tranthamkw/RCA-SBC256-SELECTRON/Images/IMG_1172.jpeg

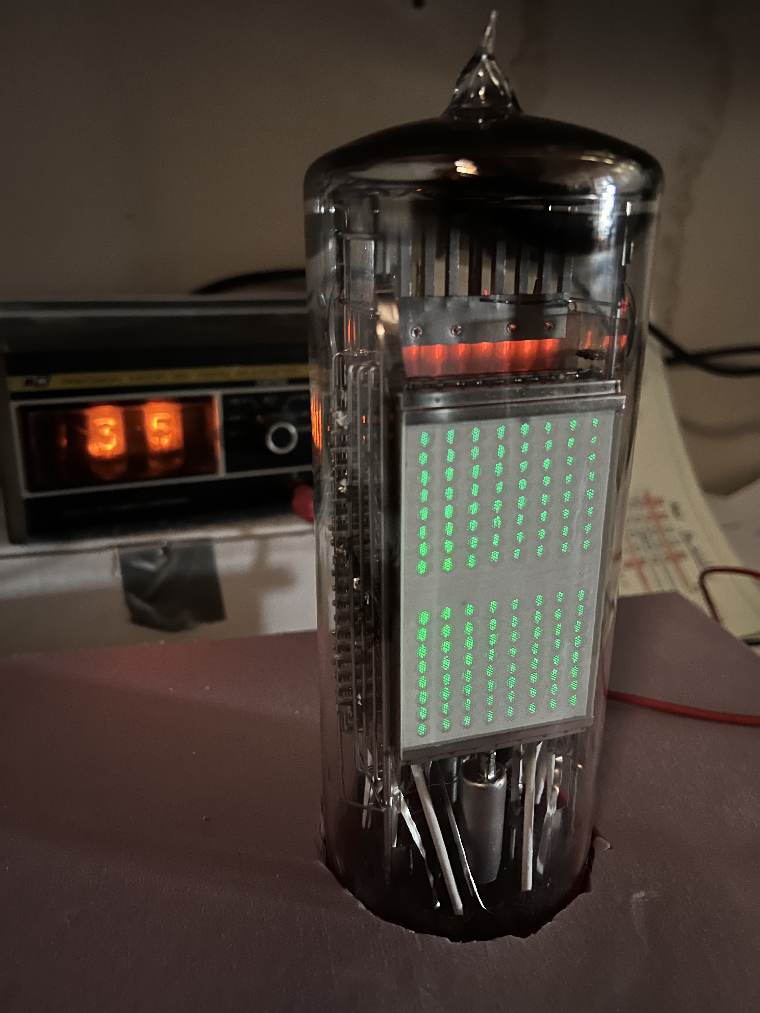
Images/IMG_1172.jpeg
