tranthamkw/RCA-SBC256-SELECTRON/Images/IMG_1291.jpeg

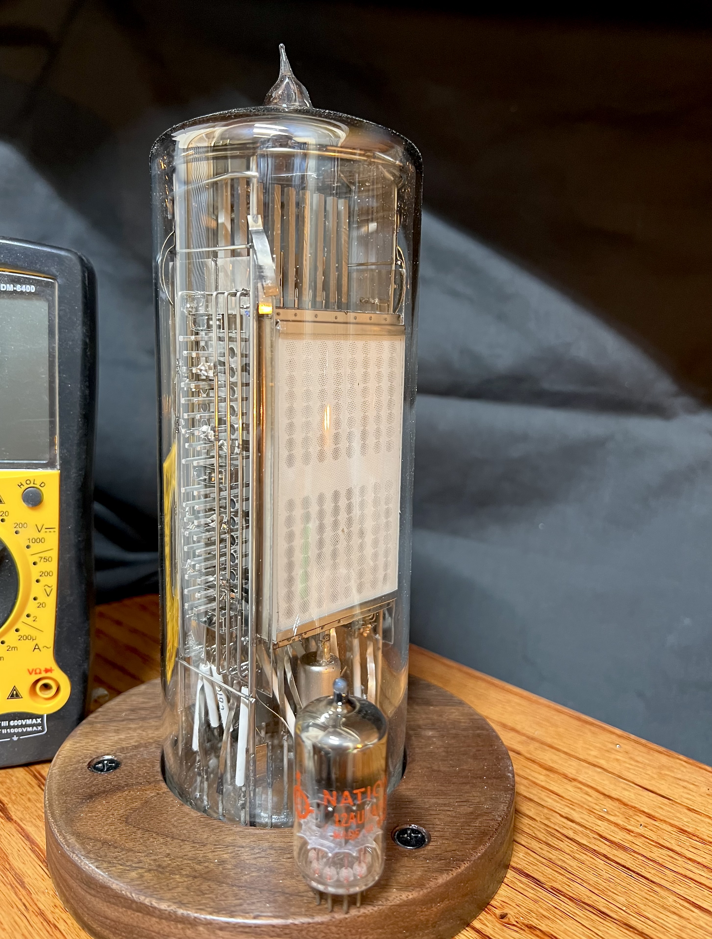
Images/IMG_1291.jpeg
