tranthamkw/RCA-SBC256-SELECTRON/barDriver/Selector Bar driver.docx

Selector Bar driver

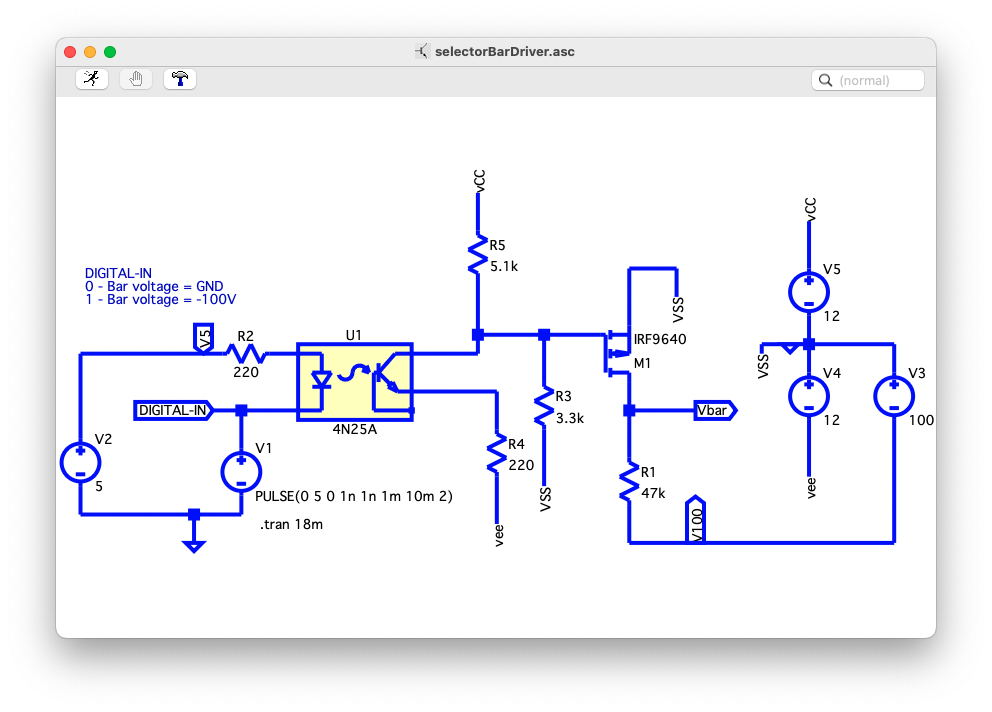
[picture p9: figure]
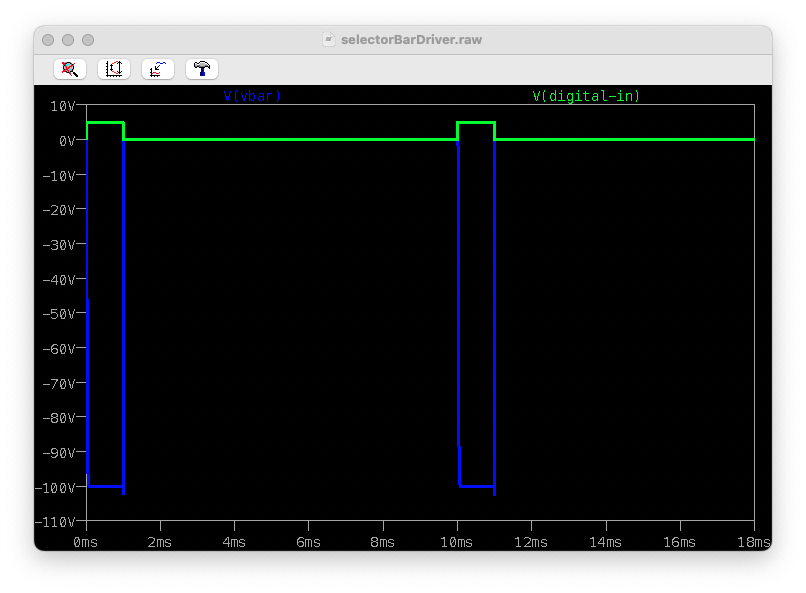
[picture p10: figure]
