tranthamkw/RCA-SBC256-SELECTRON/BarDecoder/BarDecoder.png

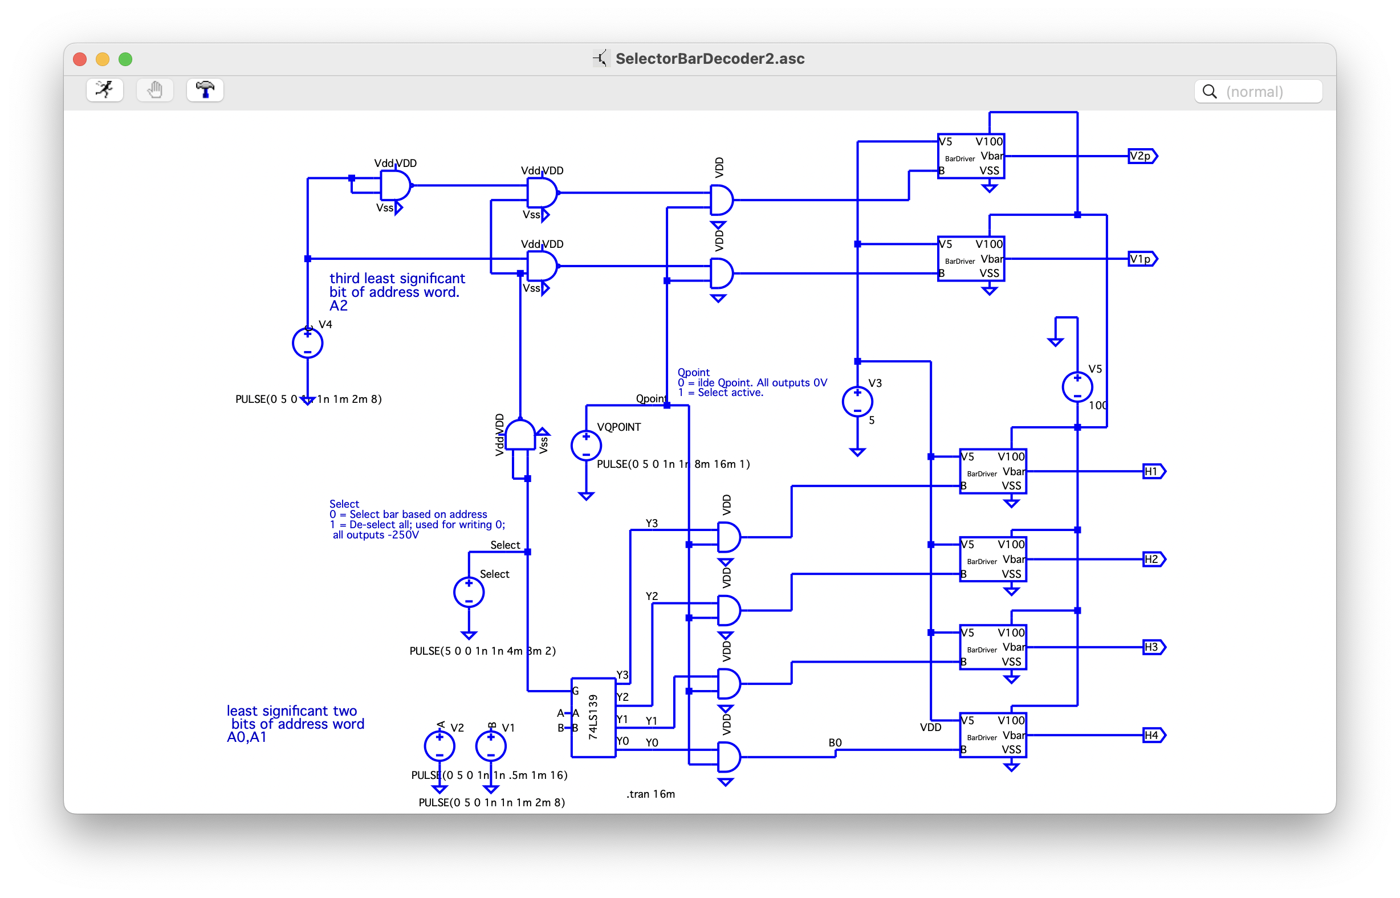
BarDecoder/BarDecoder.png
