tranthamkw/RCA-SBC256-SELECTRON/BarDecoder/IMG_1390.jpeg

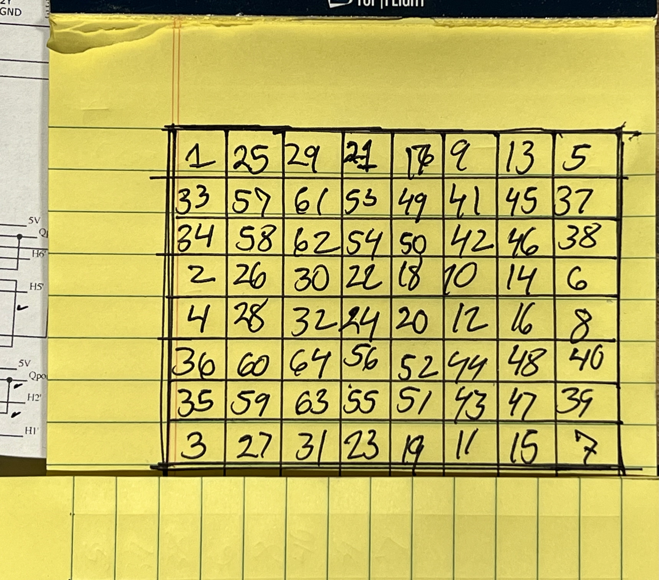
BarDecoder/IMG_1390.jpeg
