tranthamkw/RCA-SBC256-SELECTRON/barDriver/QuadDriverArrangement.png

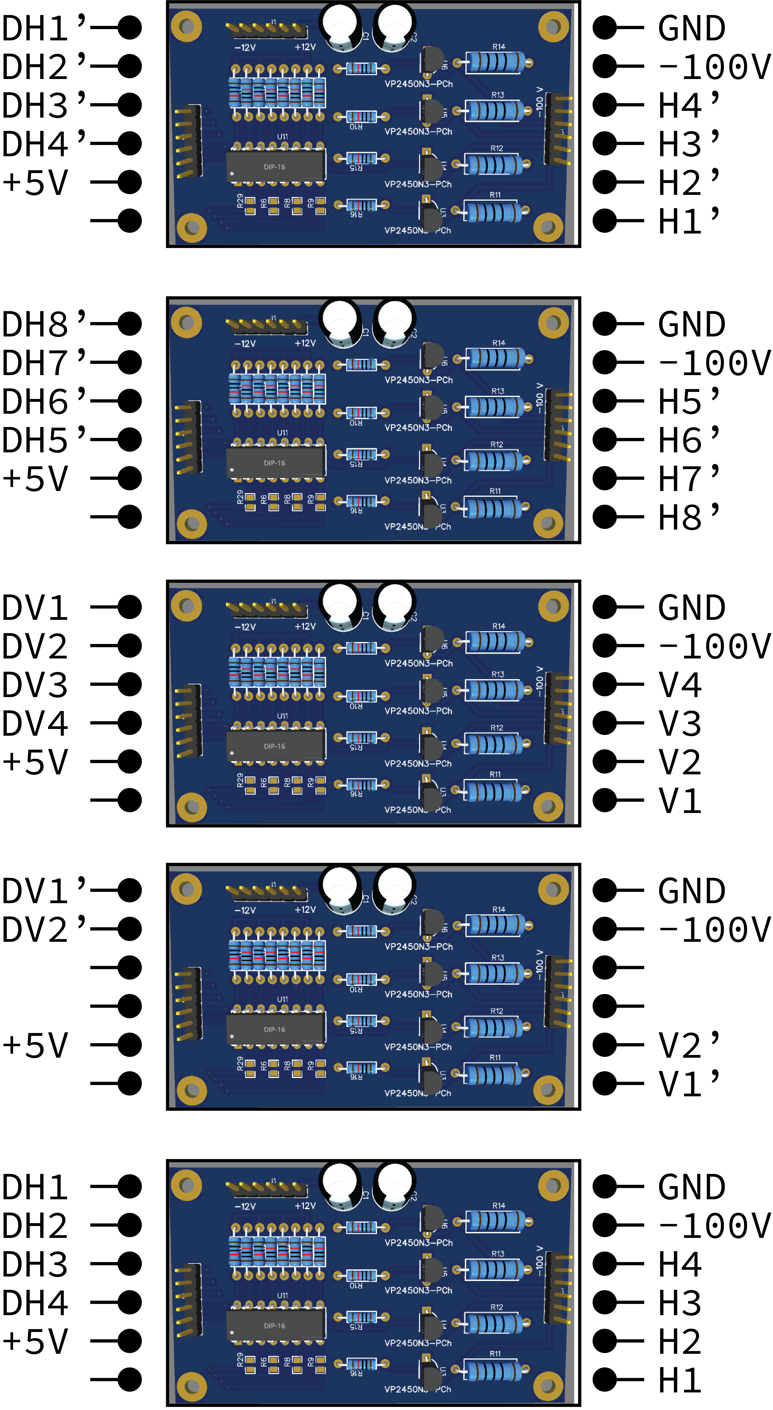
barDriver/QuadDriverArrangement.png
