tranthamkw/RCA-SBC256-SELECTRON/PIC/IMG_012.BMP

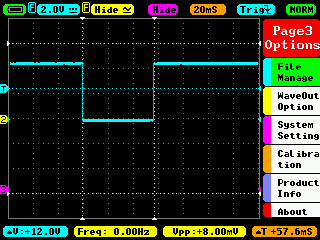
PIC/IMG_012.BMP
