tranthamkw/RCA-SBC256-SELECTRON/SchematicBlockDiagram.pdf

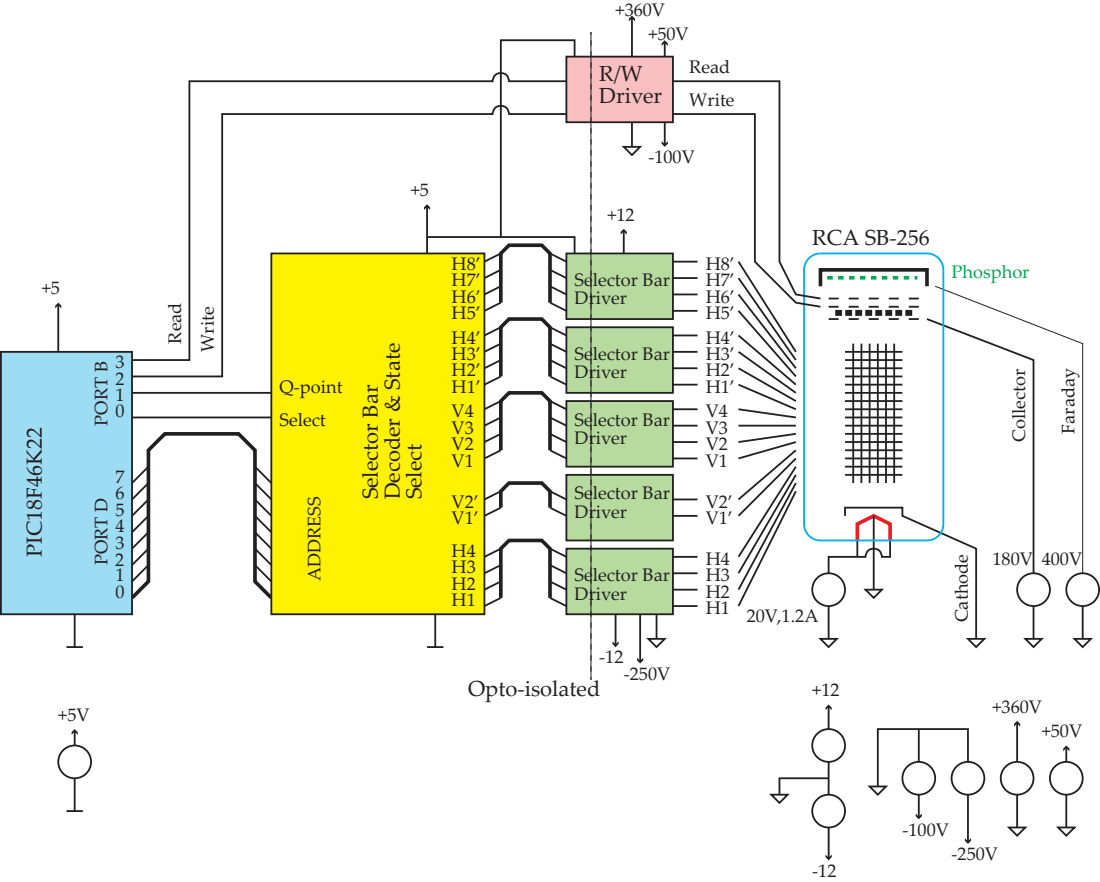
[picture p26: page 1]
PORT D; ADDRESS; Q-point Select; PIC18F46K22; PORT B 0 1; Write; Selector Bar Driver; Collector; Read; Cathode; Faraday; Phosphor; Selector Bar; Decoder & State; Select; Opto-isolated; R/W Driver; RCA SB-256
