tranthamkw/RCA-SBC256-SELECTRON/ReadDetector/Schematic_READ_AMPLIER_2026-07-07.pdf

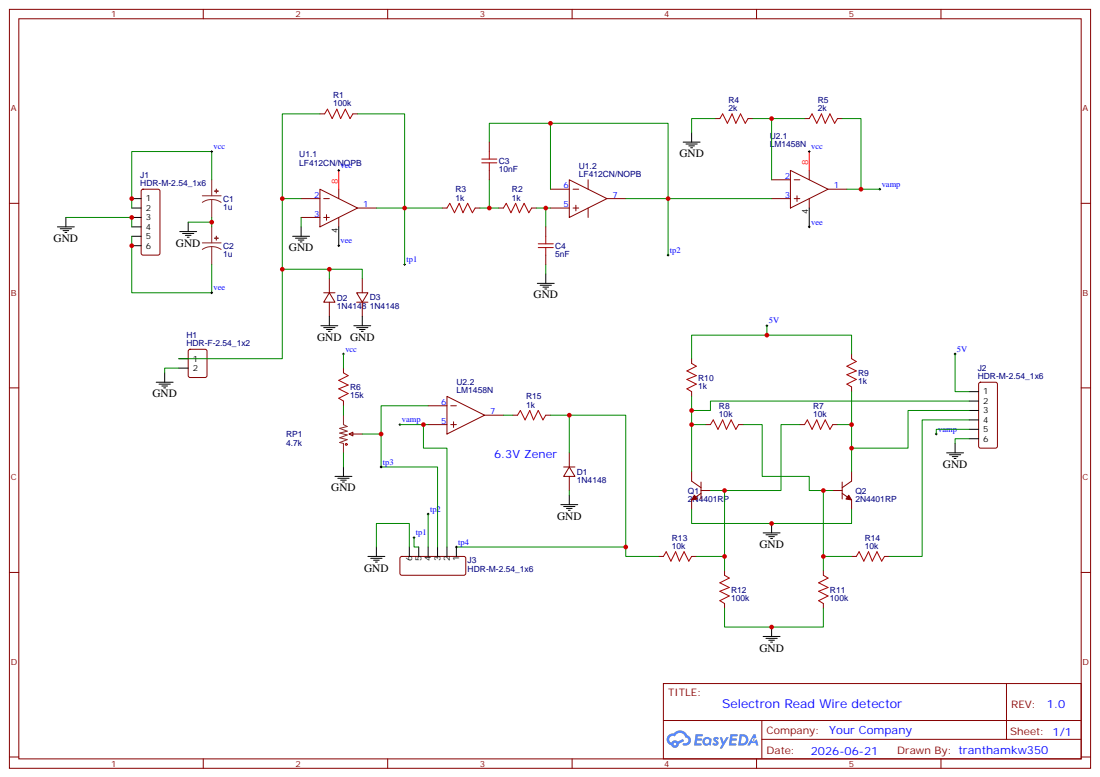
[picture p27: page 1]
