tranthamkw/RCA-SBC256-SELECTRON/ReadDetector/Schematic_READ_AMPLIER_2026-06-25.pdf

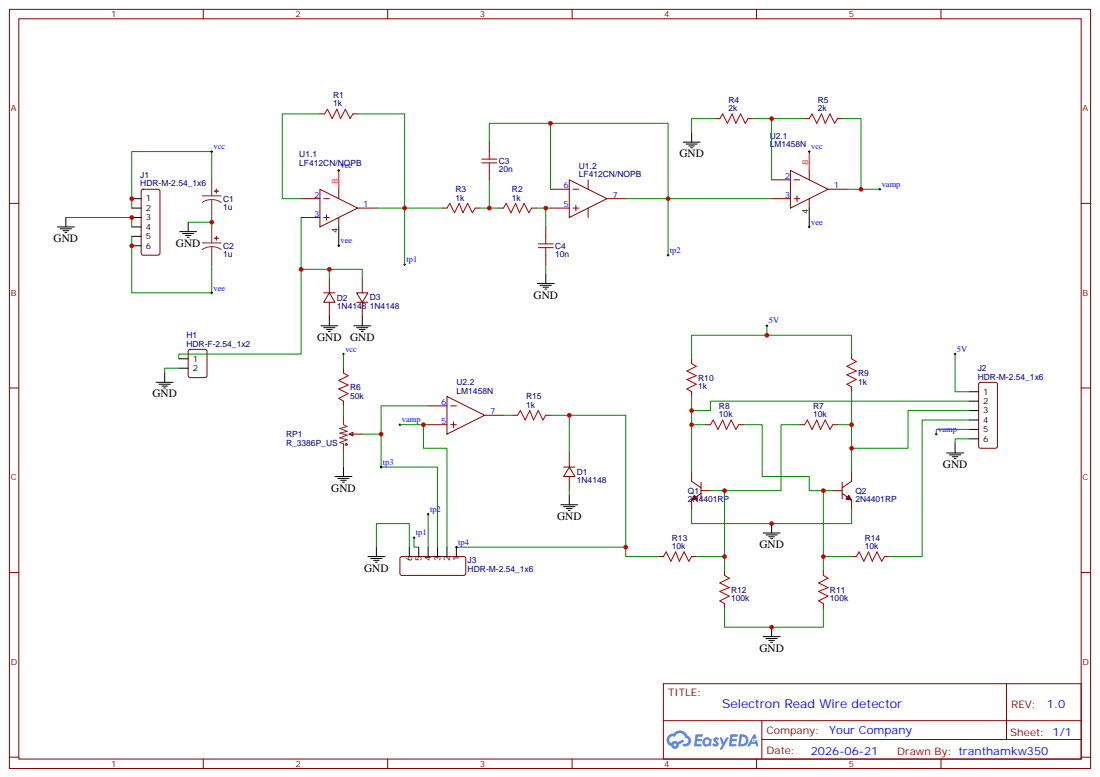
[picture p28: page 1]
