tranthamkw/RCA-SBC256-SELECTRON/PIC/Schematic_18f22k22-TEST_2026-06-07.pdf

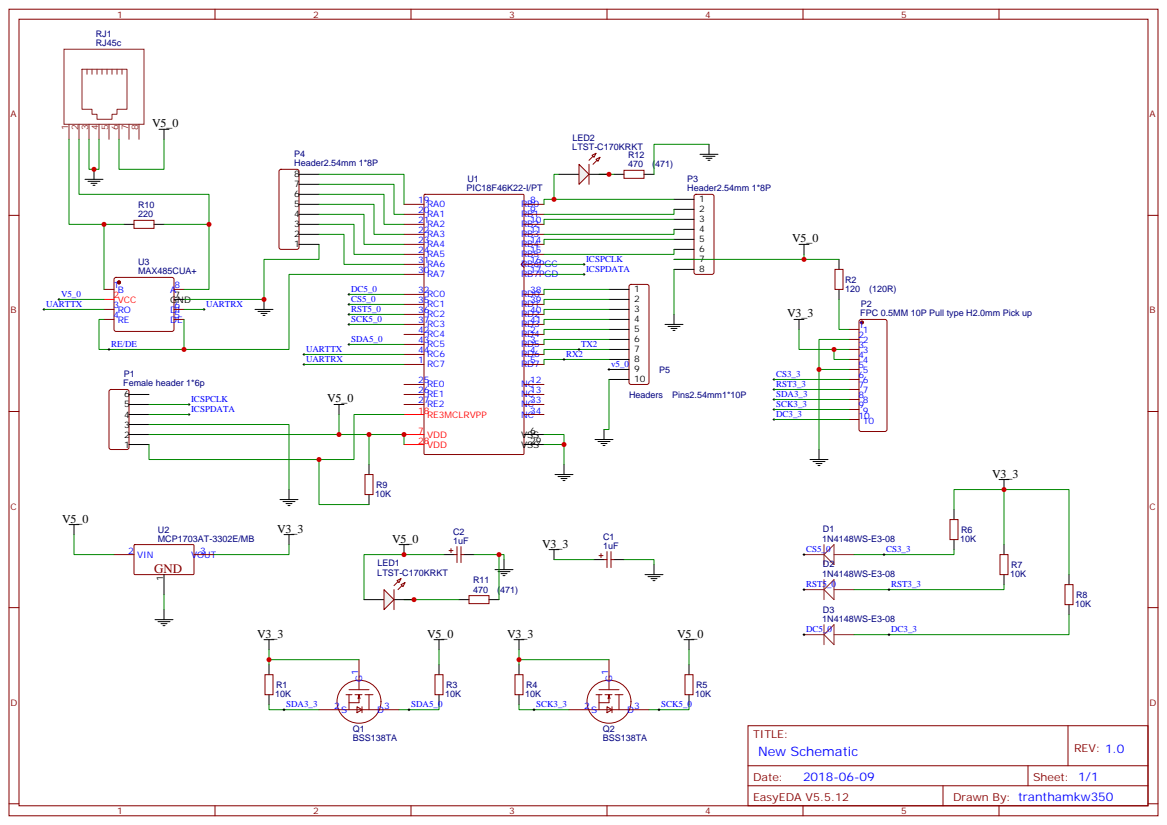
[picture p29: page 1]
