tranthamkw/RCA-SBC256-SELECTRON/BarDecoder/Schematic_SBC256BarSelector_2026-06-07.pdf

## 3B10 4Y11 4A12 4B13 VCC 14

## 3B10 4Y11 4A12 4B13 VCC 14

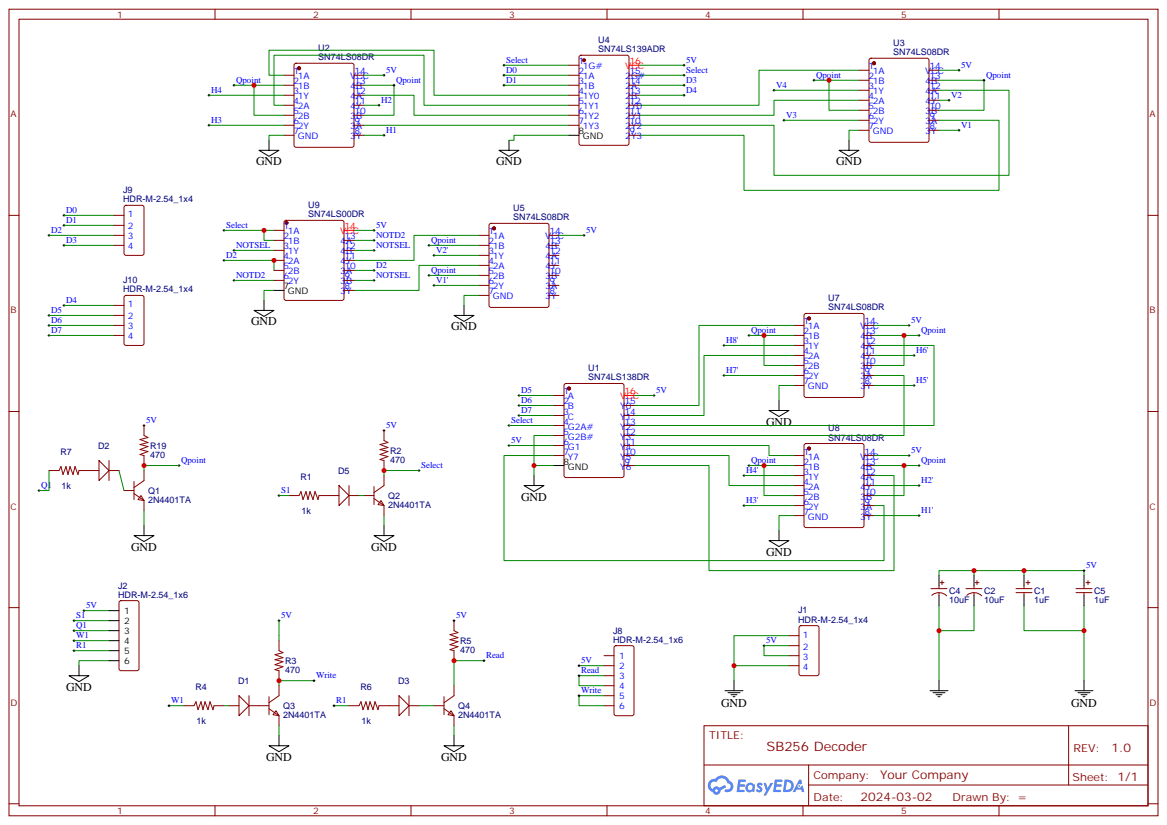
[picture p30: page 1]

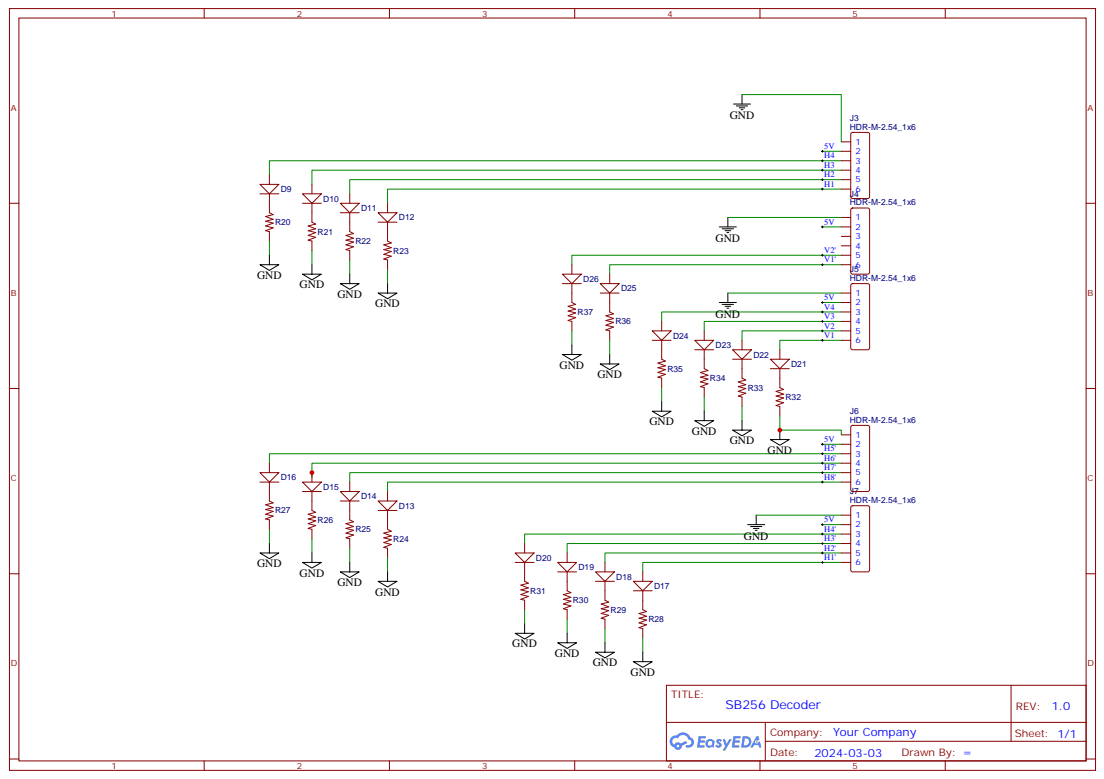
[picture p31: page 2]
