tranthamkw/RCA-SBC256-SELECTRON/ReadWriteDriver/Schematic_sb256READ-WRITE_2024-04-03.pdf

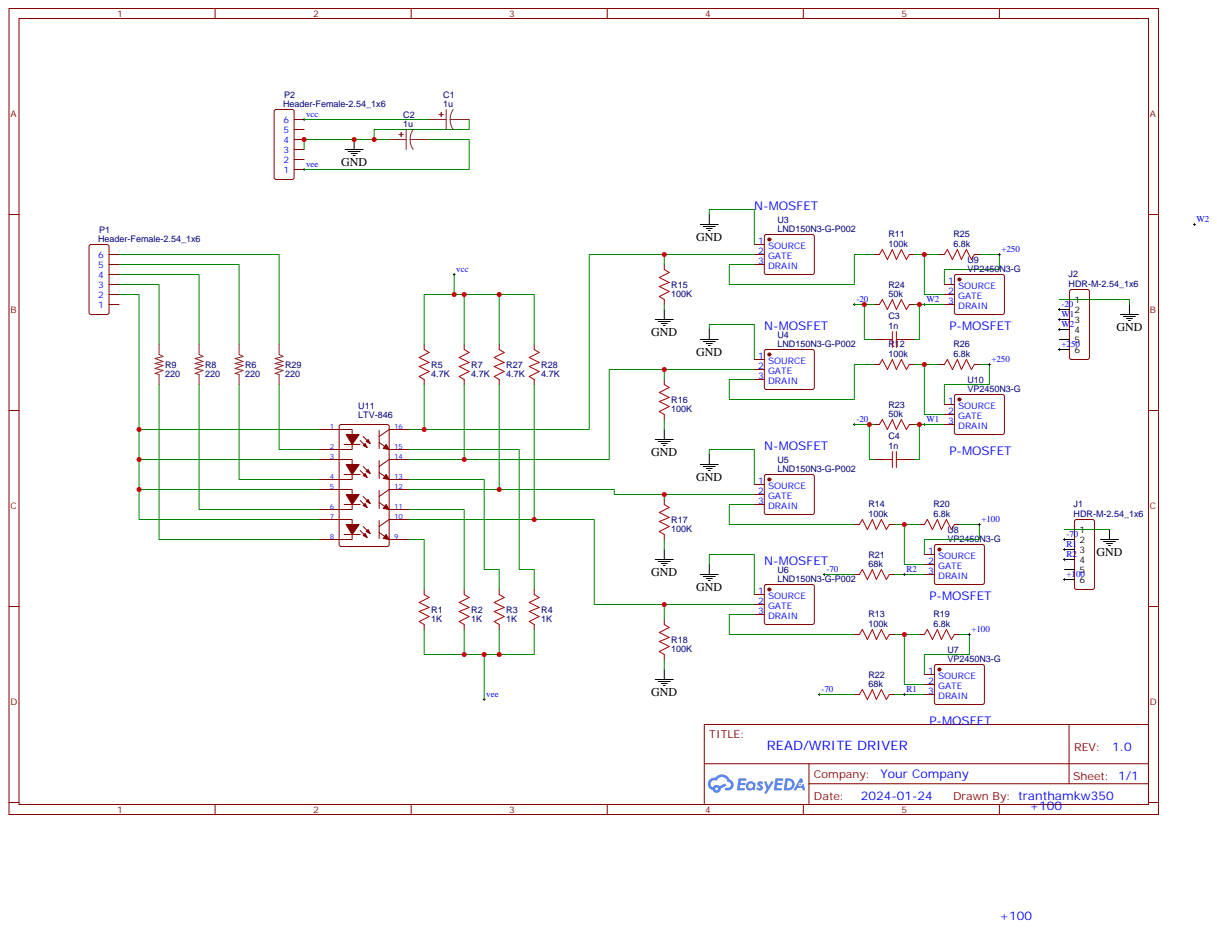
[picture p32: page 1]
