tranthamkw/RCA-SBC256-SELECTRON/BarDecoder/DRAFT_Schematic_SBC256BarSelector_2024-04-03.pdf

# 2Y2 10 2Y1 11 2Y0 12 2B 13 2A 14 2G# 15 VCC 16

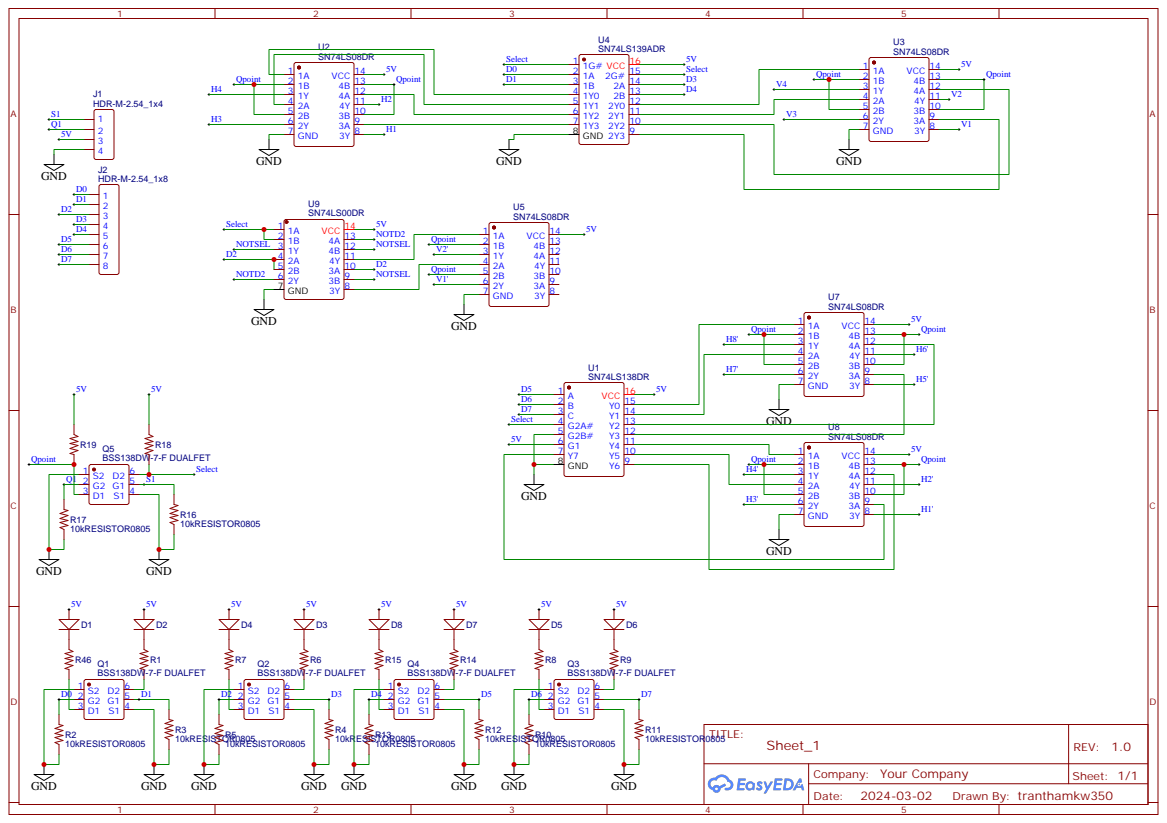
[picture p33: page 1]
