tranthamkw/RCA-SBC256-SELECTRON/barDriver/Schematic_sb256driver_2024-03-03.pdf

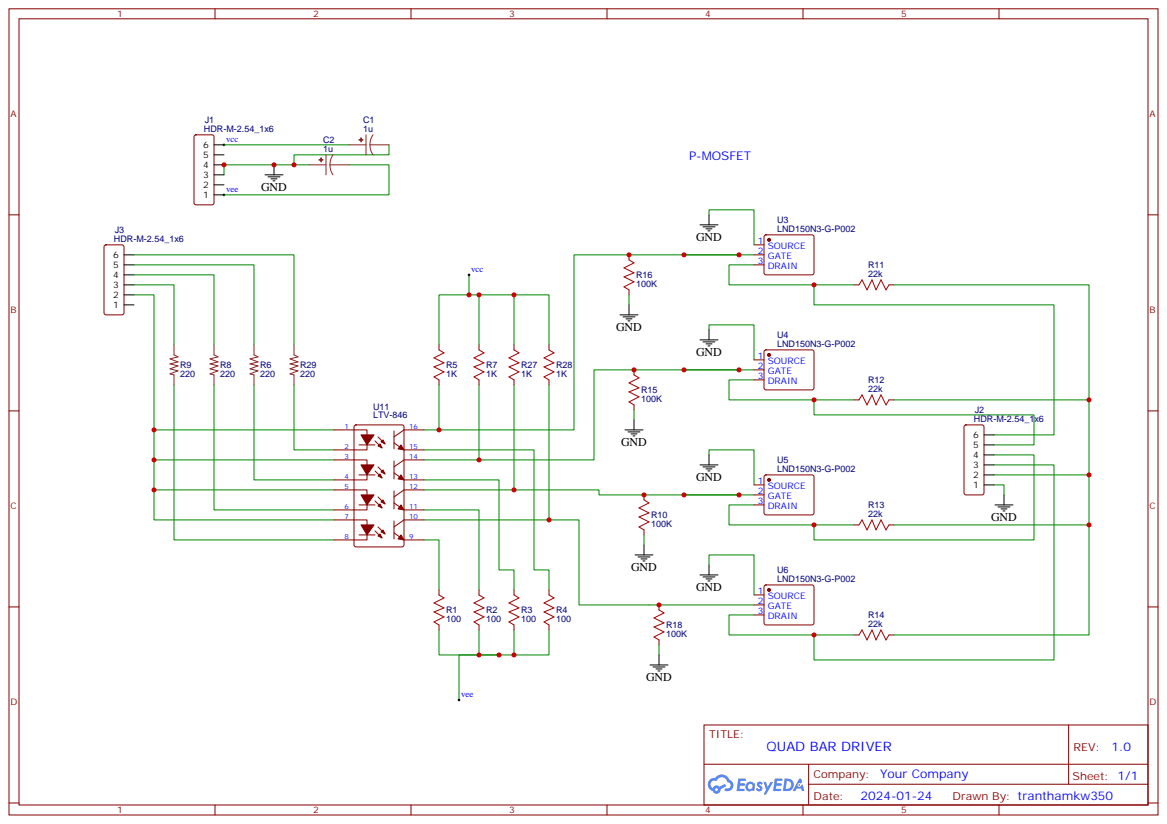
[picture p34: page 1]
