tranthamkw/RCA-SBC256-SELECTRON/ReadWriteDriver/eyeletSimWriting0.asc

C1: cap; 1p
C2: cap; 1p
Collector: voltage; 180
EyeletCurrent: bi; I={if((time<10u)|(time>15u),453.345u*exp(-0.000399261*(-114.956+V(eyelet))**2)-124.818u*exp(-0.00186908*(-31.0809+V(eyelet))**2)-388.297u/(1+exp(-0.0622775*(-155.076+V(eyelet)))),0)}
V3: voltage; PULSE(0 -250 10u 1n 1n 5u 20u 1)
WritePlate: voltage; PWL(0 0 5u 0 5.01u 360 10u 360 15u 0 20u 0)
Named nets: 0, Eyelet, Collector, WritePlate, SELECTOR-BARS
.tran 0 20u 0 100p
.ic V(eyelet)=180
