tranthamkw/RCA-SBC256-SELECTRON/ReadWriteDriver/readPlateDriver.asc

M1: pmos; IRF9640
M2: nmos; BSC100N10NSF
R1: res; 100k
R2: res; 10k
R3: res; 420
R4: res; 4.7k
R5: res; 1k
R7: res; 100k
R8: res; 5.06k
U1: 4N25
V1: voltage; 70; Rser=5
V2: voltage; PULSE(0 5 0 1n 1n 1m 10m 5)
V3: voltage; 100; Rser=5
V4: voltage; 12
V5: voltage; 12; Rser=5
V6: voltage; 5; Rser=0
Named nets: 0, vee, vCC, g, s
.tran 50m
S
D
G
