tranthamkw/RCA-SBC256-SELECTRON/ReadWriteDriver/writePlateDriver.asc

C1: cap; 2n
M1: pmos; IRF9640
M2: nmos; BSC16DN25NS3
R1: res; 100
R2: res; 50k
R3: res; 220
R5: res; 100K
R7: res; 100k
R8: res; 6.8k
R9: res; 4.7k
U2: 4N25
V1: voltage; 5; Rser=0
V2: voltage; PULSE(0 5 0 1n 1n 1m 10m 5)
V3: voltage; 250; Rser=5
V4: voltage; 12
V5: voltage; 12; Rser=5
Named nets: 0, vee, vCC
.tran 50m
