tranthamkw/RCA-SBC256-SELECTRON/BarDecoder/SelectorBarDecoder2.asc

Select: voltage; PULSE(5 0 0 1n 1n 4m 8m 2)
V1: voltage; PULSE(0 5 0 1n 1n 1m 2m 8)
V2: voltage; PULSE(0 5 0 1n 1n .5m 1m 16)
V3: voltage; 5
V4: voltage; PULSE(0 5 0 1n 1n 1m 2m 8)
V5: voltage; 100
VQPOINT: voltage; PULSE(0 5 0 1n 1n 8m 16m 1)
X1: 74LS139
X2: AND
X3: AND
X4: AND
X5: AND
X6: selectorBarDriver
X7: selectorBarDriver
X8: selectorBarDriver
X9: selectorBarDriver
X10: AND
X11: AND
X12: selectorBarDriver
X13: selectorBarDriver
X14: NAND
X15: NAND
X16: NAND
X17: NAND
Named nets: 0, A, B, H4, H3, H2, H1, VDD, Qpoint, Select, Y0, Y1, Y2, Y3, B0, C, V1p, V2p
.tran 16m
Qpoint
0 = ilde Qpoint. All outputs 0V
1 = Select active.
Select
0 = Select bar based on address
1 = De-select all; used for writing 0;
 all outputs -250V
least significant two
 bits of address word
A0,A1
third least significant
bit of address word. 
A2
