tranthamkw/RCA-SBC256-SELECTRON/barDriver/selectorBarDriver.asc

M1: pmos; IRF9640
R1: res; 47k
R2: res; 220
R3: res; 3.3k
R4: res; 220
R5: res; 5.1k
U1: 4N25A
V1: voltage; PULSE(0 5 0 1n 1n 1m 10m 2)
V2: voltage; 5
V3: voltage; 100
V4: voltage; 12
V5: voltage; 12; Rser=5
Named nets: vee, vCC, Vbar, V100, DIGITAL-IN, V5, VSS, 0
.tran 18m
DIGITAL-IN
0 - Bar voltage = GND
1 - Bar voltage = -100V
