tranthamkw/RCA-SBC256-SELECTRON/(commit log)

2024-04-03 Add files via upload
    How the drivers are organized
2024-04-04 Add files via upload
    Block diagram
    For specific schematics for each block, see appropriate folder in the repository.
2026-06-08 Add files via upload
    device for decoding required selector bars based on a given address. also provides interface for setting Q-point, reading, and writing
2026-07-04 Update main.c
    moved SB256 specific functions to its own .h .c library
    also slowly moving down the delay time in write/read. currently 100uS
